ClemensElflein/xESC2040/PCB/xESC2.kicad_pcb

## KiCad design PCB/xESC2.kicad_pcb (2022-09-01)

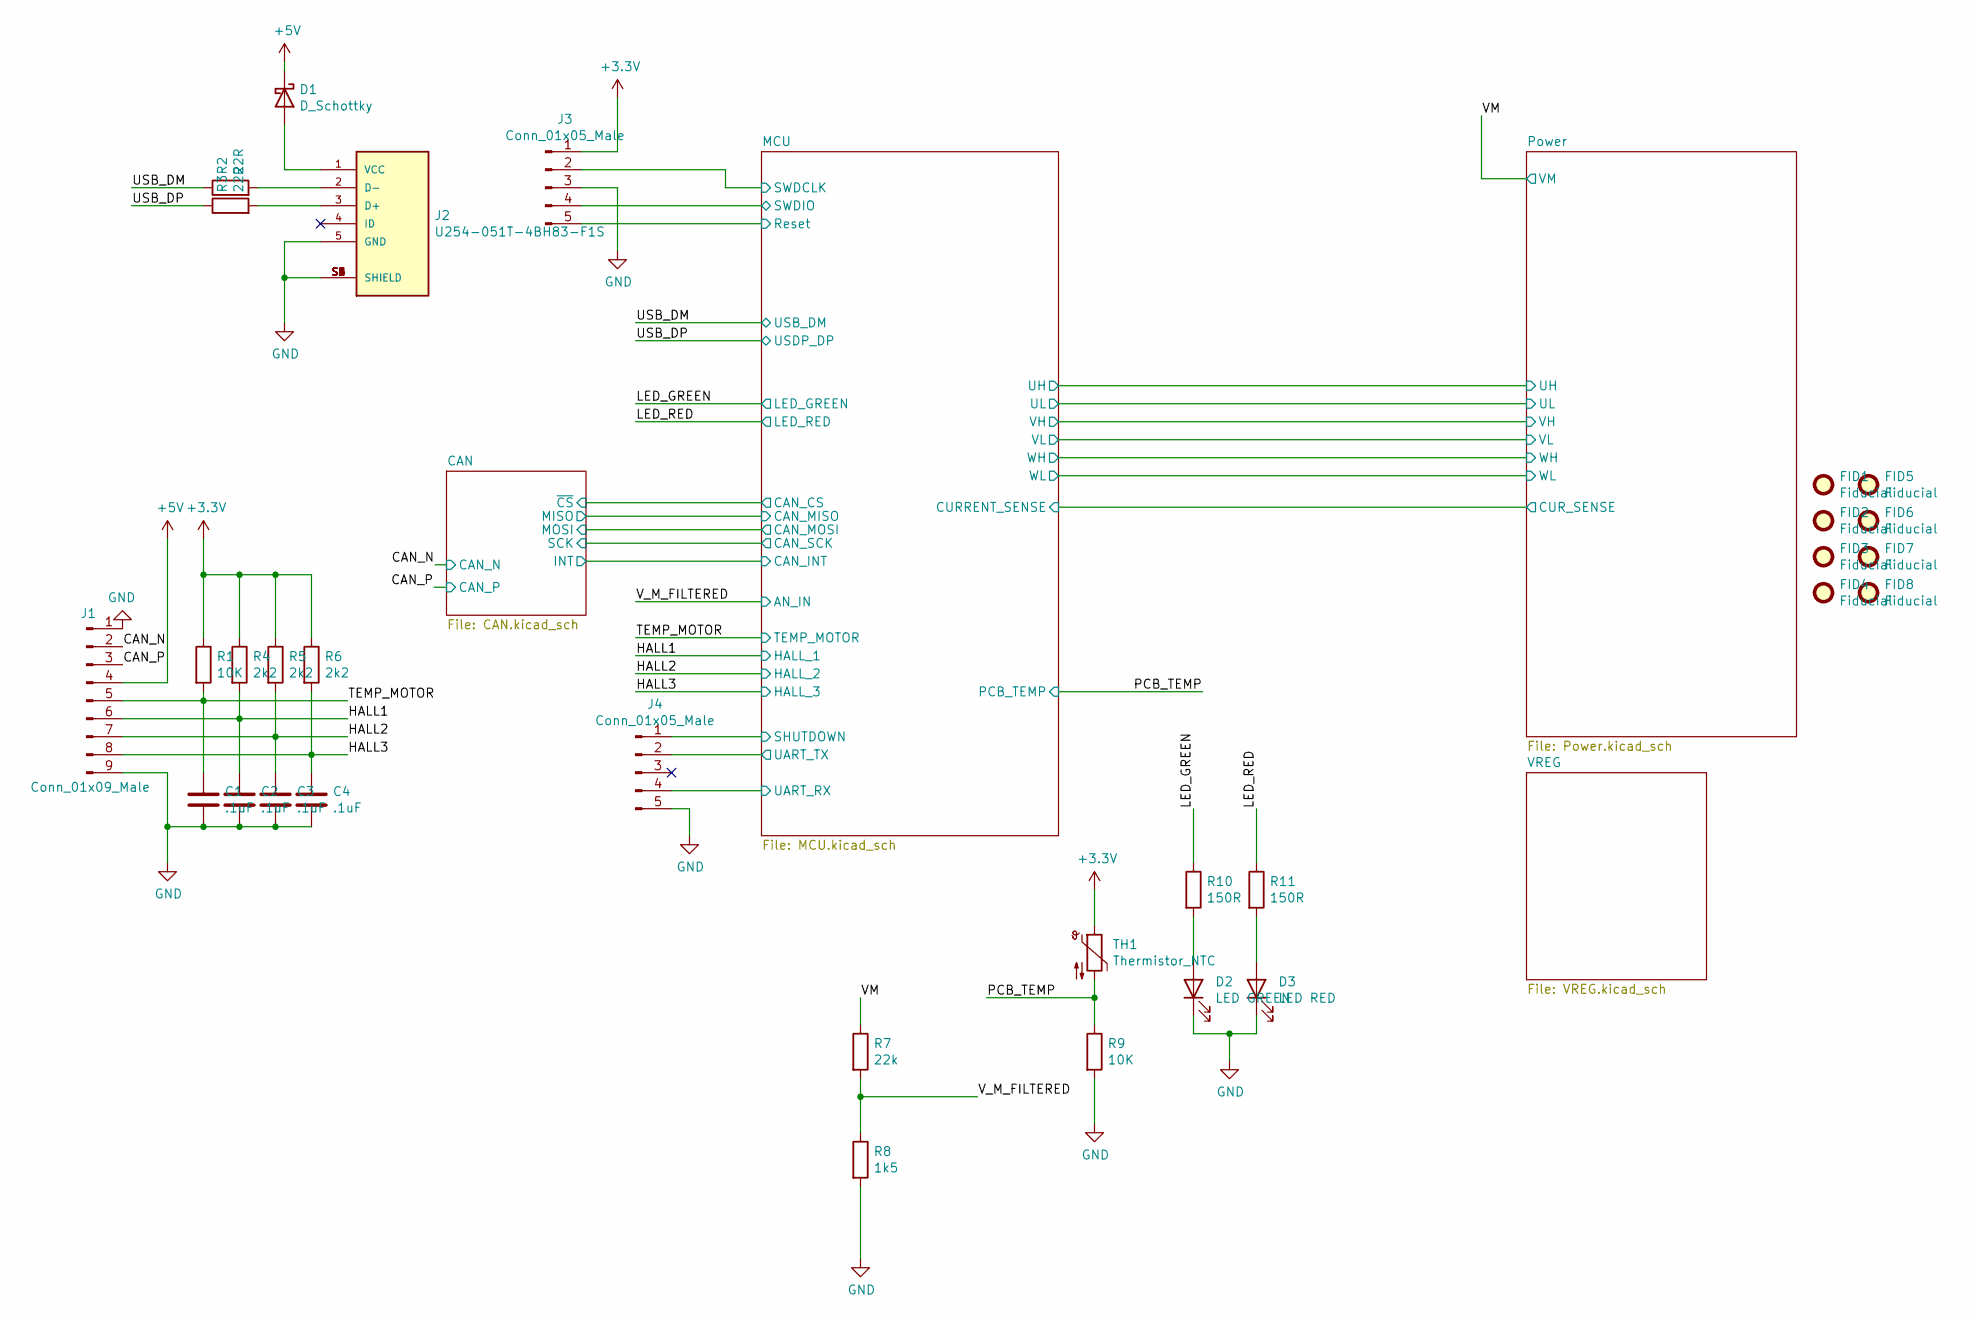
[picture p1: schematic xESC2.kicad_sch, xESC BLDC Controller]

Parts:
C1, C2, C3, C4: .1uF; C_0603_1608Metric; Part Number CL10B104KC8NNNC; Digikey 1276-1935-1-ND
D1: D_Schottky; D_SOD-123; Part Number PMEG2010ER,115; Digikey 1727-5192-1-ND
D2: LED GREEN; LED_0603_1608Metric; Part Number LTST-C191KGKT; Digikey 160-1446-1-ND
D3: LED RED; LED_0603_1608Metric; Part Number LTST-C191KRKT; Digikey 160-1447-1-ND
FID1, FID2, FID3, FID4, FID5, FID6, FID7, FID8: Fiducial; Fiducial_0.75mm_Mask1.5mm
J1: Conn_01x09_Male; PinHeader_1x09_P2.54mm_Vertical; Part Number DZ254R-11-09-63; LCSC C2935915
J2: U254-051T-4BH83-F1S; XKB_U254-051T-4BH83-F1S; PARTREV A0; LCSC C397452
J3, J4: Conn_01x05_Male; PinHeader_1x05_P2.54mm_Vertical; Part Number DZ254R-11-05-63; LCSC C2935911
R1, R9: 10K; R_0603_1608Metric; Part Number RC0603FR-0710KL; Digikey 311-10.0KHRCT-ND
R2, R3: 22R; R_0603_1608Metric; Part Number RMCF0603FT22R0; Digikey RMCF0603FT22R0CT-ND
R4, R5, R6: 2k2; R_0603_1608Metric; Part Number RC0603FR-072K2L; Digikey 311-2.20KHRCT-ND
R7: 22k; R_0603_1608Metric; Part Number RMCF0603FT22K0; Digikey RMCF0603FT22K0CT-ND
R8: 1k5; R_0603_1608Metric; Part Number RC0603FR-071K5L; Digikey 311-1.50KHRCT-ND
R10, R11: 150R; R_0603_1608Metric; Part Number RC0603FR-07150RL; Digikey 311-150HRCT-ND
TH1: Thermistor_NTC; R_0603_1608Metric; Part Number NCU18XH103F60RB; Digikey 490-16279-1-ND

Connections:
+3V3: J3.1, R1.1, R4.1, R5.1, R6.1, TH1.1; also elsewhere on the board
+5V: D1.1 (K), J1.4; also elsewhere on the board
/CAN_N: J1.2; also elsewhere on the board
/CAN_P: J1.3; also elsewhere on the board
/HALL1: C2.1, J1.6, R4.2; also elsewhere on the board
/HALL2: C3.1, J1.7, R5.2; also elsewhere on the board
/HALL3: C4.1, J1.8, R6.2; also elsewhere on the board
/LED_GREEN: R10.1; also elsewhere on the board
/LED_RED: R11.1; also elsewhere on the board
/MCU/Reset: J3.5; also elsewhere on the board
/MCU/SHUTDOWN: J4.1; also elsewhere on the board
/MCU/SWDCLK: J3.2; also elsewhere on the board
/MCU/SWDIO: J3.4; also elsewhere on the board
/MCU/UART_RX: J4.4; also elsewhere on the board
/MCU/UART_TX: J4.2; also elsewhere on the board
/PCB_TEMP: R9.1, TH1.2; also elsewhere on the board
/TEMP_MOTOR: C1.1, J1.5, R1.2; also elsewhere on the board
/USB_DM: R2.1; also elsewhere on the board
/USB_DP: R3.1; also elsewhere on the board
/VM: R7.1; also elsewhere on the board
/V_M_FILTERED: R7.2, R8.1; also elsewhere on the board
GND: C1.2, C2.2, C3.2, C4.2, D2.1 (K), D3.1 (K), J1.1, J1.9, J2.5 (GND), J2.S1 (SHIELD), J2.S2 (SHIELD), J2.S3 (SHIELD), J2.S4 (SHIELD), J2.S5 (SHIELD), J2.S6 (SHIELD), J3.3, J4.5, R8.2, R9.2; also elsewhere on the board
unnamed: D1.2 (A), J2.1 (VCC)
unnamed: D2.2 (A), R10.2
unnamed: D3.2 (A), R11.2
unnamed: J2.2 (D-), R2.2
unnamed: J2.3 (D+), R3.2

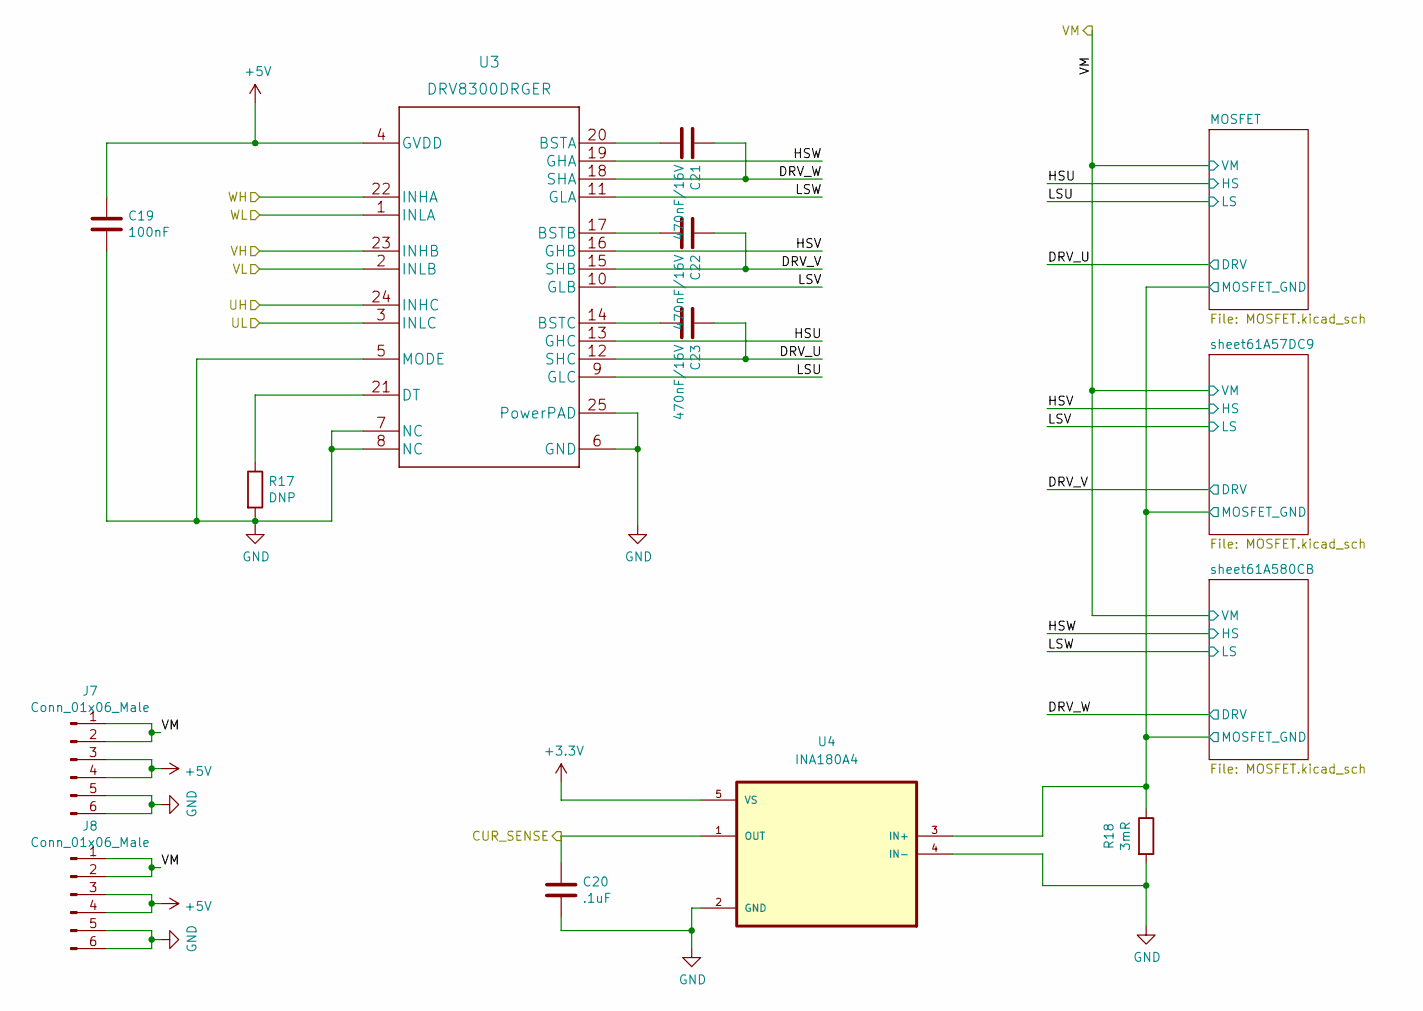
[picture p2: schematic Power.kicad_sch, xESC BLDC Controller]

Parts:
C19: 100nF; C_0603_1608Metric; Part Number CL10B104KC8NNNC; Digikey 1276-6807-1-ND
C20: .1uF; C_0603_1608Metric; Part Number CL10B104KC8NNNC; Digikey 1276-1935-1-ND
C21, C22, C23: 470nF/16V; C_0603_1608Metric; Part Number CL10B474KO8NNNC; Digikey 1276-1062-1-ND
J7, J8: Conn_01x06_Male; PinHeader_1x06_P2.54mm_Vertical; Part Number DZ254R-11-06-63; LCSC C2935912
R17: DNP; R_0603_1608Metric; Part Number RC0603FR-0710KL; Digikey 311-10.0KHRCT-ND
R18: 3mR; R_2512_6332Metric; Part Number ARP2512GJR033; LCSC C2889925
U3: DRV8300DRGER; VQFN-24-1EP_4x4mm_P0.5mm_EP2.45x2.45mm; Part Number DRV8300DRGER; Digikey 296-DRV8300DRGERCT-ND
U4: INA180A4; SOT95P280X145-5N; Part Number INA180A3IDBVR; Digikey 296-47654-1-ND

Connections:
+3V3: U4.5 (VS); also elsewhere on the board
+5V: C19.1, J7.3, J7.4, J8.3, J8.4, U3.4 (GVDD); also elsewhere on the board
/MCU/CURRENT_SENSE: C20.1, U4.1 (OUT); also elsewhere on the board
/MCU/UH: U3.24 (INHC); also elsewhere on the board
/MCU/UL: U3.3 (INLC); also elsewhere on the board
/MCU/VH: U3.23 (INHB); also elsewhere on the board
/MCU/VL: U3.2 (INLB); also elsewhere on the board
/MCU/WH: U3.22 (INHA); also elsewhere on the board
/MCU/WL: U3.1 (INLA); also elsewhere on the board
/Power/DRV_U: C23.1, U3.12 (SHC); also elsewhere on the board
/Power/DRV_V: C22.1, U3.15 (SHB); also elsewhere on the board
/Power/DRV_W: C21.1, U3.18 (SHA); also elsewhere on the board
/Power/HSU: U3.13 (GHC); also elsewhere on the board
/Power/HSV: U3.16 (GHB); also elsewhere on the board
/Power/HSW: U3.19 (GHA); also elsewhere on the board
/Power/LSU: U3.9 (GLC); also elsewhere on the board
/Power/LSV: U3.10 (GLB); also elsewhere on the board
/Power/LSW: U3.11 (GLA); also elsewhere on the board
/Power/MOSFET/MOSFET_GND: R18.1, U4.3 (IN+); also elsewhere on the board
/VM: J7.1, J7.2, J8.1, J8.2; also elsewhere on the board
GND: C19.2, C20.2, J7.5, J7.6, J8.5, J8.6, R17.2, R18.2, U3.5 (MODE), U3.6 (GND), U3.7 (NC), U3.8 (NC), U3.25 (PowerPAD), U4.2 (GND), U4.4 (IN-); also elsewhere on the board
unnamed: C21.2, U3.20 (BSTA)
unnamed: C22.2, U3.17 (BSTB)
unnamed: C23.2, U3.14 (BSTC)
unnamed: R17.1, U3.21 (DT)

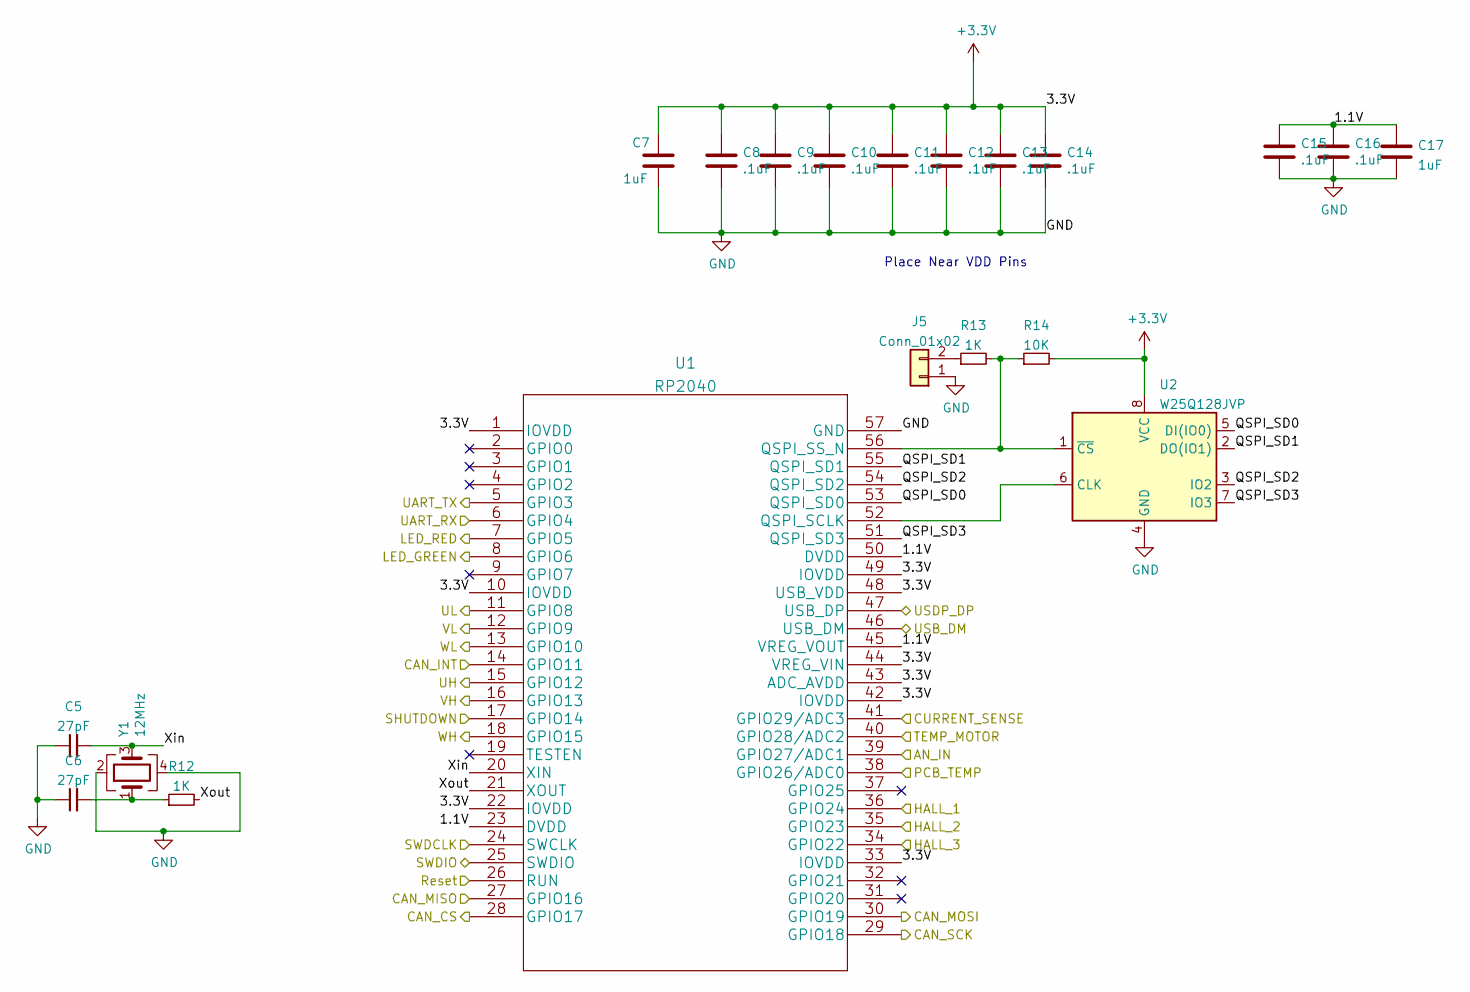
[picture p3: schematic MCU.kicad_sch, xESC BLDC Controller]

Parts:
C5, C6: 27pF; C_0603_1608Metric; Part Number CC0603JRNPO9BN270; Digikey 311-1063-1-ND
C7, C17: 1uF; C_0603_1608Metric; Part Number CL10B105KA8NNNC; Digikey 490-13409-1-ND
C8, C9, C10, C11, C12, C13, C14, C15, C16: .1uF; C_0603_1608Metric; Part Number CL10B104KC8NNNC; Digikey 1276-1935-1-ND
J5: Conn_01x02; PinHeader_1x02_P2.54mm_Vertical; Part Number DZ254R-11-02-63; LCSC C2935908
R12, R13: 1K; R_0603_1608Metric; Part Number RC0603FR-071KL; Digikey 311-1.00KHRDKR-ND
R14: 10K; R_0603_1608Metric; Part Number RC0603FR-0710KL; Digikey 311-10.0KHRCT-ND
U1: RP2040; Part Number SC0914(13); Digikey 2648-SC0914(13)CT-ND
U2: W25Q128JVP; WSON-8-1EP_6x5mm_P1.27mm_EP3.4x4.3mm; Part Number W25Q128JVPIM; Digikey W25Q128JVPIMCT-ND
Y1: 12MHz; Crystal_SMD_3225-4Pin_3.2x2.5mm; Part Number ECS-120-18-33-JGN-TR3; Digikey 50-ECS-120-18-33-JGN-TR3CT-ND

Connections:
+3V3: C7.1, C8.1, C9.1, C10.1, C11.1, C12.1, C13.1, C14.1, R14.2, U1.1 (IOVDD), U1.10 (IOVDD), U1.22 (IOVDD), U1.33 (IOVDD), U1.42 (IOVDD), U1.43 (ADC_AVDD), U1.44 (VREG_VIN), U1.48 (USB_VDD), U1.49 (IOVDD), U2.8 (VCC); also elsewhere on the board
/CAN/INT: U1.14 (GPIO11); also elsewhere on the board
/CAN/MISO: U1.27 (GPIO16); also elsewhere on the board
/CAN/MOSI: U1.30 (GPIO19); also elsewhere on the board
/CAN/SCK: U1.29 (GPIO18); also elsewhere on the board
/CAN/~CS: U1.28 (GPIO17); also elsewhere on the board
/HALL1: U1.36 (GPIO24); also elsewhere on the board
/HALL2: U1.35 (GPIO23); also elsewhere on the board
/HALL3: U1.34 (GPIO22); also elsewhere on the board
/LED_GREEN: U1.8 (GPIO6); also elsewhere on the board
/LED_RED: U1.7 (GPIO5); also elsewhere on the board
/MCU/1.1V: C15.1, C16.1, C17.1, U1.23 (DVDD), U1.45 (VREG_VOUT), U1.50 (DVDD)
/MCU/CURRENT_SENSE: U1.41 (GPIO29/ADC3); also elsewhere on the board
/MCU/QSPI_SD0: U1.53 (QSPI_SD0), U2.5 (DI(IO0))
/MCU/QSPI_SD1: U1.55 (QSPI_SD1), U2.2 (DO(IO1))
/MCU/QSPI_SD2: U1.54 (QSPI_SD2), U2.3 (IO2)
/MCU/QSPI_SD3: U1.51 (QSPI_SD3), U2.7 (IO3)
/MCU/Reset: U1.26 (RUN); also elsewhere on the board
/MCU/SHUTDOWN: U1.17 (GPIO14); also elsewhere on the board
/MCU/SWDCLK: U1.24 (SWCLK); also elsewhere on the board
/MCU/SWDIO: U1.25 (SWDIO); also elsewhere on the board
/MCU/UART_RX: U1.6 (GPIO4); also elsewhere on the board
/MCU/UART_TX: U1.5 (GPIO3); also elsewhere on the board
/MCU/UH: U1.15 (GPIO12); also elsewhere on the board
/MCU/UL: U1.11 (GPIO8); also elsewhere on the board
/MCU/VH: U1.16 (GPIO13); also elsewhere on the board
/MCU/VL: U1.12 (GPIO9); also elsewhere on the board
/MCU/WH: U1.18 (GPIO15); also elsewhere on the board
/MCU/WL: U1.13 (GPIO10); also elsewhere on the board
/MCU/Xin: C5.2, U1.20 (XIN), Y1.3
/MCU/Xout: R12.2, U1.21 (XOUT)
/PCB_TEMP: U1.38 (GPIO26/ADC0); also elsewhere on the board
/TEMP_MOTOR: U1.40 (GPIO28/ADC2); also elsewhere on the board
/USB_DM: U1.46 (USB_DM); also elsewhere on the board
/USB_DP: U1.47 (USB_DP); also elsewhere on the board
/V_M_FILTERED: U1.39 (GPIO27/ADC1); also elsewhere on the board
GND: C5.1, C6.1, C7.2, C8.2, C9.2, C10.2, C11.2, C12.2, C13.2, C14.2, C15.2, C16.2, C17.2, J5.1, U1.57 (GND), U2.4 (GND), Y1.2, Y1.4; also elsewhere on the board
unnamed: C6.2, R12.1, Y1.1
unnamed: J5.2, R13.1
unnamed: R13.2, R14.1, U1.56 (QSPI_SS_N), U2.1 (~CS)
unnamed: U1.52 (QSPI_SCLK), U2.6 (CLK)

Notes on the sheet:
Place Near VDD Pins

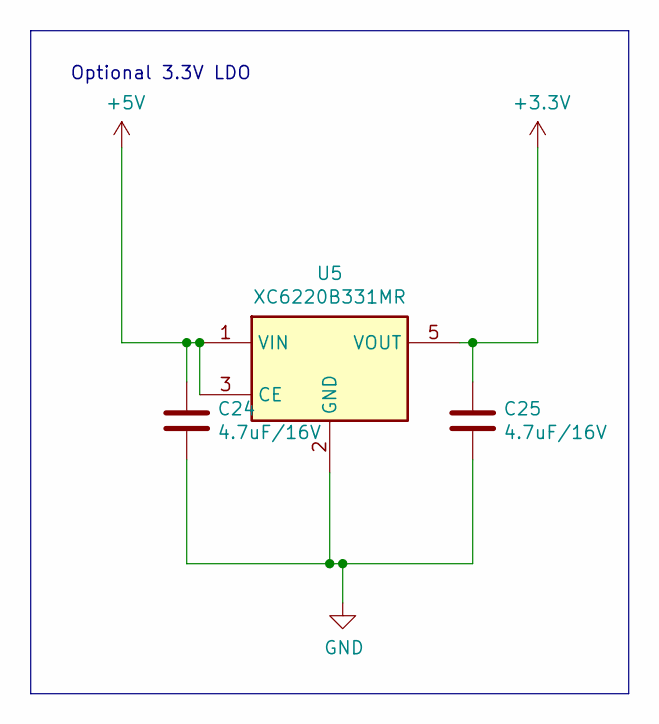
[picture p4: schematic VREG.kicad_sch, xESC BLDC Controller]

Parts:
C24, C25: 4.7uF/16V; C_0603_1608Metric; Part Number CL21A106KOQNNNE; Digikey 1276-1096-2-ND
U5: XC6220B331MR; SOT-23-5; Part Number XC6220B331MR; Digikey 893-1133-1-ND

Connections:
+3V3: C25.1, U5.5 (VOUT); also elsewhere on the board
+5V: C24.1, U5.1 (VIN), U5.3 (CE); also elsewhere on the board
GND: C24.2, C25.2, U5.2 (GND); also elsewhere on the board

Notes on the sheet:
Optional 3.3V LDO

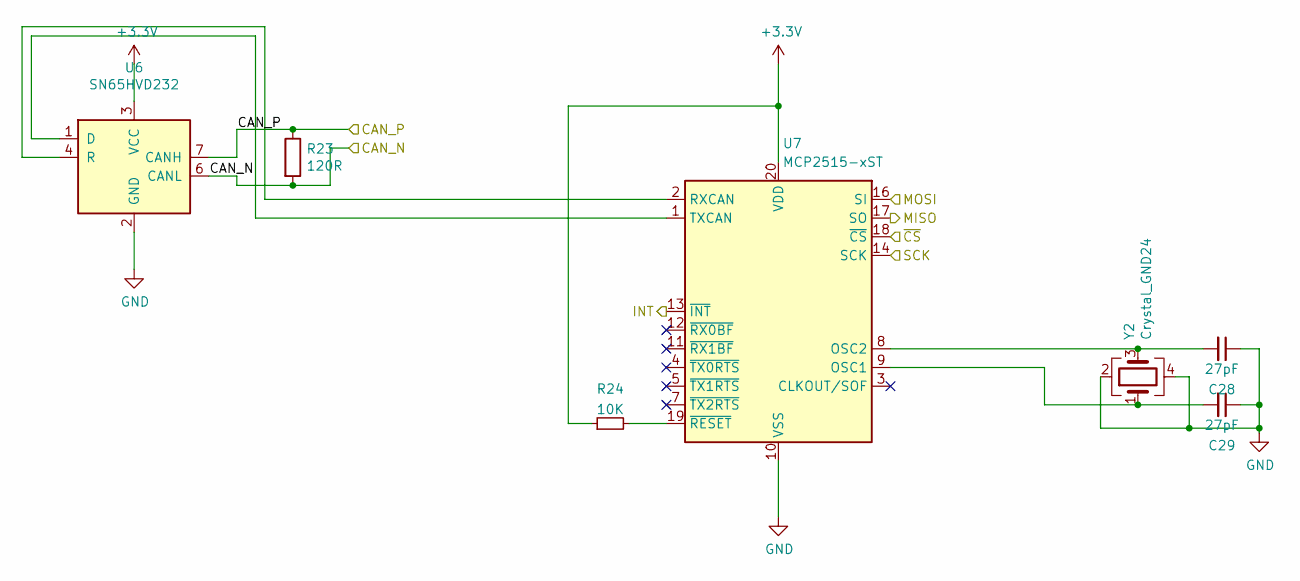
[picture p5: schematic CAN.kicad_sch]

Parts:
C28, C29: 27pF; C_0603_1608Metric; Part Number CC0603JRNPO9BN270; Digikey 311-1063-1-ND
R23: 120R; R_0805_2012Metric; Part Number RMCF0805FT120R; Digikey 738-RMCF0805FT120RCT-ND
R24: 10K; R_0603_1608Metric; Part Number RC0603FR-0710KL; Digikey 311-10.0KHRCT-ND
U6: SN65HVD232; SOIC-8_3.9x4.9mm_P1.27mm; Part Number SN65HVD232; Digikey 296-12282-5-ND
U7: MCP2515-xST; TSSOP-20_4.4x6.5mm_P0.65mm; Part Number MCP2515-E/ST; Digikey MCP2515-E/ST-ND
Y2: Crystal_GND24; Crystal_SMD_3225-4Pin_3.2x2.5mm; Part Number ECS-80-12-33-JGN-TR; Digikey 50-ECS-80-12-33-JGN-CT-ND

Connections:
+3V3: R24.1, U6.3 (VCC), U7.20 (VDD); also elsewhere on the board
/CAN/INT: U7.13 (~INT); also elsewhere on the board
/CAN/MISO: U7.17 (SO); also elsewhere on the board
/CAN/MOSI: U7.16 (SI); also elsewhere on the board
/CAN/SCK: U7.14 (SCK); also elsewhere on the board
/CAN/~CS: U7.18 (~CS); also elsewhere on the board
/CAN_N: R23.2, U6.6 (CANL); also elsewhere on the board
/CAN_P: R23.1, U6.7 (CANH); also elsewhere on the board
GND: C28.1, C29.1, U6.2 (GND), U7.10 (VSS), Y2.2, Y2.4; also elsewhere on the board
unnamed: C28.2, U7.8 (OSC2), Y2.3
unnamed: C29.2, U7.9 (OSC1), Y2.1
unnamed: R24.2, U7.19 (~RESET)
unnamed: U6.1 (D), U7.1 (TXCAN)
unnamed: U6.4 (R), U7.2 (RXCAN)

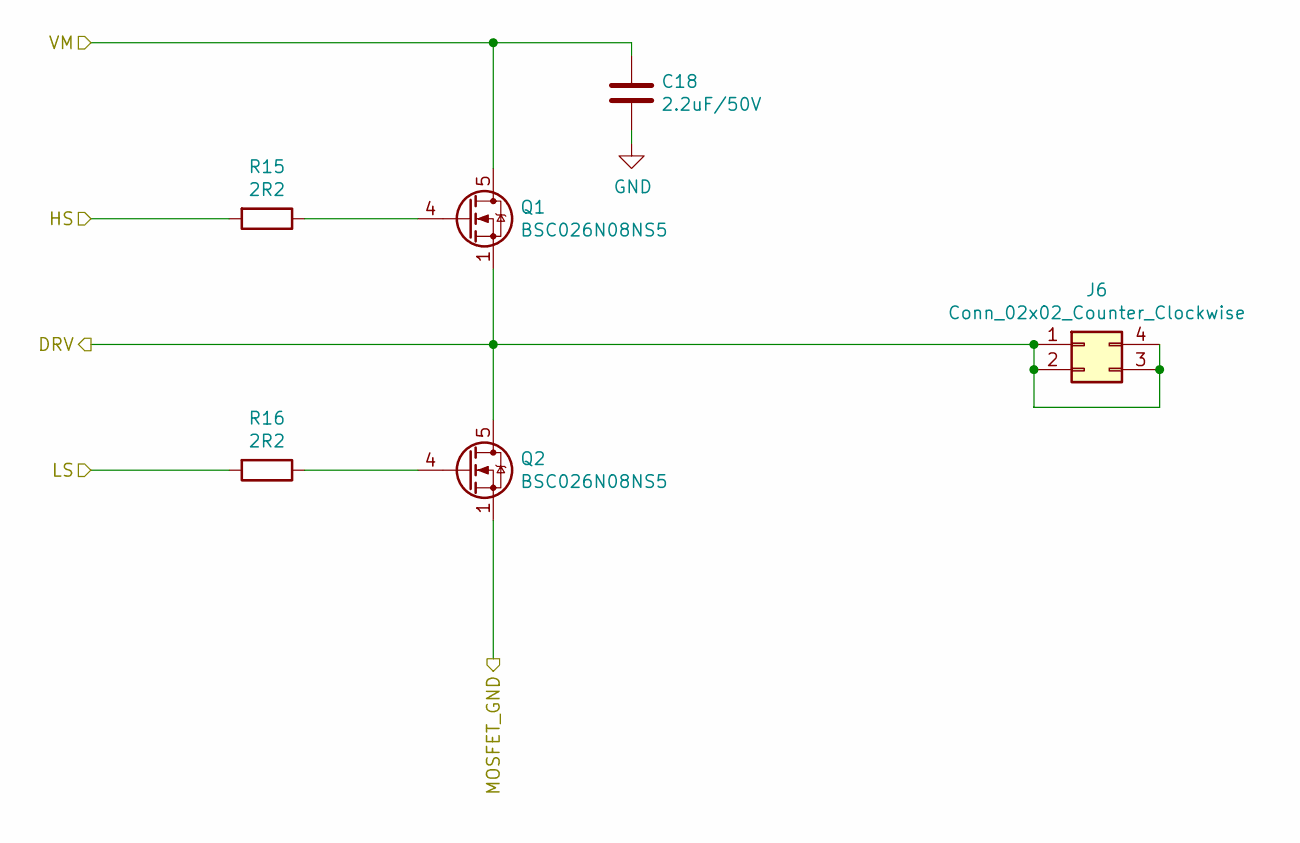
[picture p6: schematic MOSFET.kicad_sch, xESC BLDC Controller]

Parts:
C18: 2.2uF/50V; C_1206_3216Metric; Part Number CL31B225KBHVPNE; Digikey 1276-6735-1-ND
J6: Conn_02x02_Counter_Clockwise; PinHeader_2x02_P2.54mm_Vertical; Part Number B-2100S04P-B110; LCSC C124362
Q1, Q2: BSC026N08NS5; TDSON-8-1; Part Number C919592; Digikey BSC026N08NS5ATMA1CT-ND
R15, R16: 2R2; R_0603_1608Metric; Part Number ERJ-3GEYJ2R2V; Digikey P2.2GCT-ND

Connections:
/Power/DRV_U: J6.1, J6.2, J6.3, J6.4, Q1.1 (S), Q1.2 (S), Q1.3 (S), Q2.5 (D); also elsewhere on the board
/Power/HSU: R15.2; also elsewhere on the board
/Power/LSU: R16.2; also elsewhere on the board
/Power/MOSFET/MOSFET_GND: Q2.1 (S), Q2.2 (S), Q2.3 (S); also elsewhere on the board
/VM: C18.1, Q1.5 (D); also elsewhere on the board
GND: C18.2; also elsewhere on the board
unnamed: Q1.4 (G), R15.1
unnamed: Q2.4 (G), R16.1

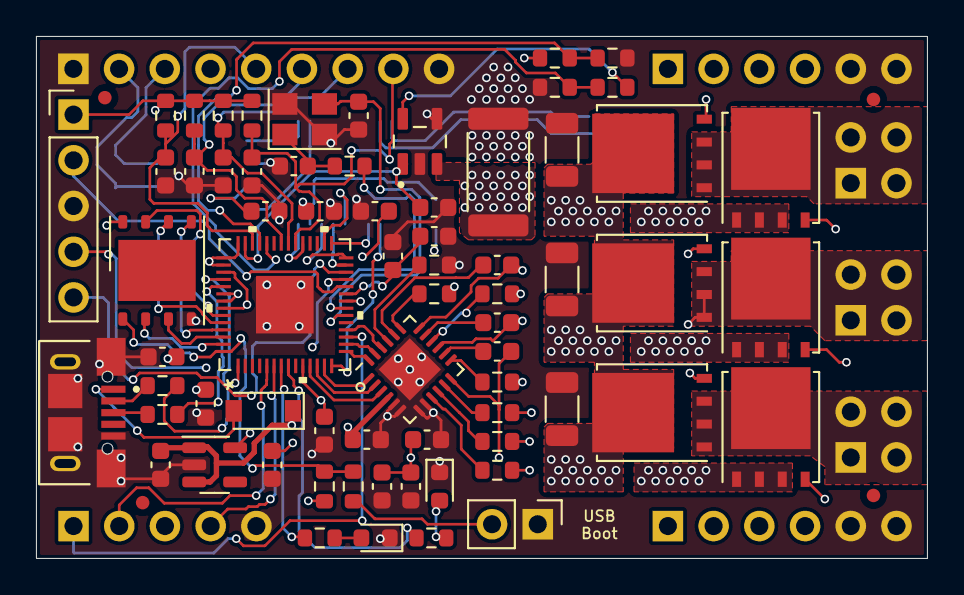
[picture p7: board xESC2.kicad_pcb from above]

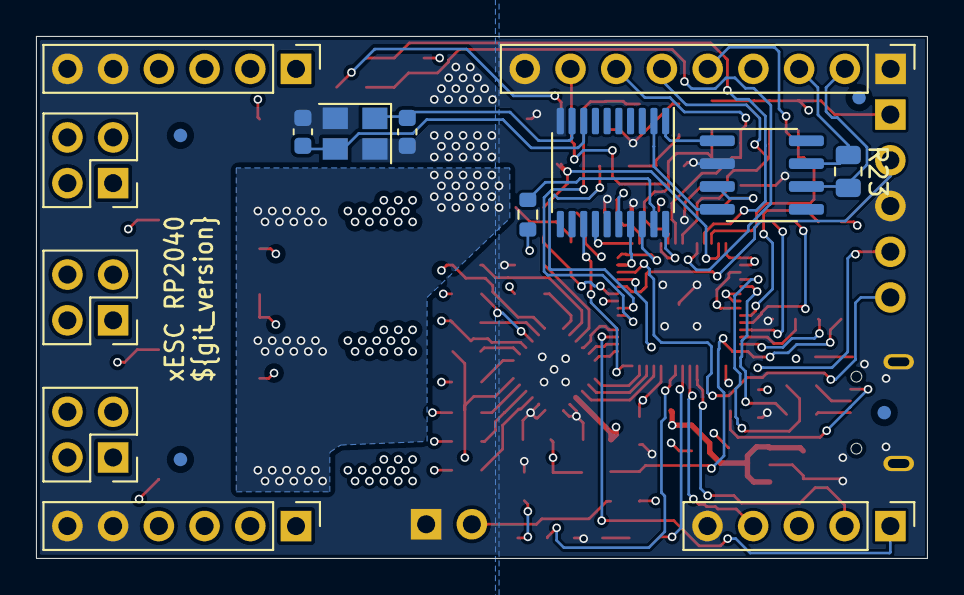
[picture p8: board xESC2.kicad_pcb from below]

Board: 4 copper layers, 49.5 x 29.0 mm, 90 parts (18 on the bottom side), 75 nets.

Other parts of the board:
C26, C27: 2.2uF/50V; C_1206_3216Metric
J9, J10: Conn_02x02_Counter_Clockwise; PinHeader_2x02_P2.54mm_Vertical
Q3, Q4, Q5, Q6: BSC026N08NS5; TDSON-8-1
R19, R20, R21, R22: 2R2; R_0603_1608Metric

Their connections:
/Power/DRV_V: J9.1, J9.2, J9.3, J9.4, Q3.1 (S), Q3.2 (S), Q3.3 (S), Q4.5 (D); also elsewhere on the board
/Power/DRV_W: J10.1, J10.2, J10.3, J10.4, Q5.1 (S), Q5.2 (S), Q5.3 (S), Q6.5 (D); also elsewhere on the board
/Power/HSV: R19.2; also elsewhere on the board
/Power/HSW: R21.2; also elsewhere on the board
/Power/LSV: R20.2; also elsewhere on the board
/Power/LSW: R22.2; also elsewhere on the board
/Power/MOSFET/MOSFET_GND: Q4.1 (S), Q4.2 (S), Q4.3 (S), Q6.1 (S), Q6.2 (S), Q6.3 (S); also elsewhere on the board
/VM: C26.1, C27.1, Q3.5 (D), Q5.5 (D); also elsewhere on the board
GND: C26.2, C27.2; also elsewhere on the board
unnamed: Q3.4 (G), R19.1
unnamed: Q4.4 (G), R20.1
unnamed: Q5.4 (G), R21.1
unnamed: Q6.4 (G), R22.1
