ClemensElflein/xESC2040/firmware/src/pins.h

#pragma once

#define PIN_UH 12
#define PIN_VH 13
#define PIN_WH 15
#define PIN_UL 8
#define PIN_VL 9
#define PIN_WL 10
#define PIN_CURRENT_SENSE 29
#define PIN_TEMP_MOTOR 28
#define PIN_TEMP_PCB 26
#define PIN_VIN 27

#define PIN_HALL_U 24
#define PIN_HALL_V 23
#define PIN_HALL_W 22

#define PIN_LED_RED 5
#define PIN_LED_GREEN 6
