ClemensElflein/xESC2040/(commit log)

2022-07-14 chore: rearrange folders
    [CAN.kicad_sch, MCU.kicad_sch, MOSFET.kicad_sch, Power.kicad_sch, VREG.kicad_sch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]
2022-07-14 feat(GH): KiBot configuration
    [xESC2.kicad_pcb]
2022-07-15 feat(kibot): KiBot filters to resemble KiCad
2022-07-15 fix: mark C28, C29, R24 as `+can`
    [CAN.kicad_sch]
2022-07-20 Update MCU.kicad_sch
    fixed crystal ref
    [MCU.kicad_sch]
2022-07-24 fix(VREG): update C24,C25 value to 10uF to match DigiKey
    [VREG.kicad_sch]
2022-08-14 fix(power): update PNs for R18 shunt
    [Power.kicad_sch]
2022-08-26 added .1uF for C2-C4
    [MOSFET.kicad_sch, VREG.kicad_sch, xESC2.kicad_pcb, xESC2.kicad_sch]
2022-09-01 fix(pcb): reference RP2040_QFN from GrabCAD
    [xESC2.kicad_pcb]
2022-09-01 typo: thermistor
2022-09-30 fix: remove testing leftover
    [main.cpp]
2023-01-19 Fixed direction computation and comments
    [main.cpp, xesc_2040_datatypes.h]
